al-chris/GEOFENCE/hardware/kicad/geofence_lawnmower.png

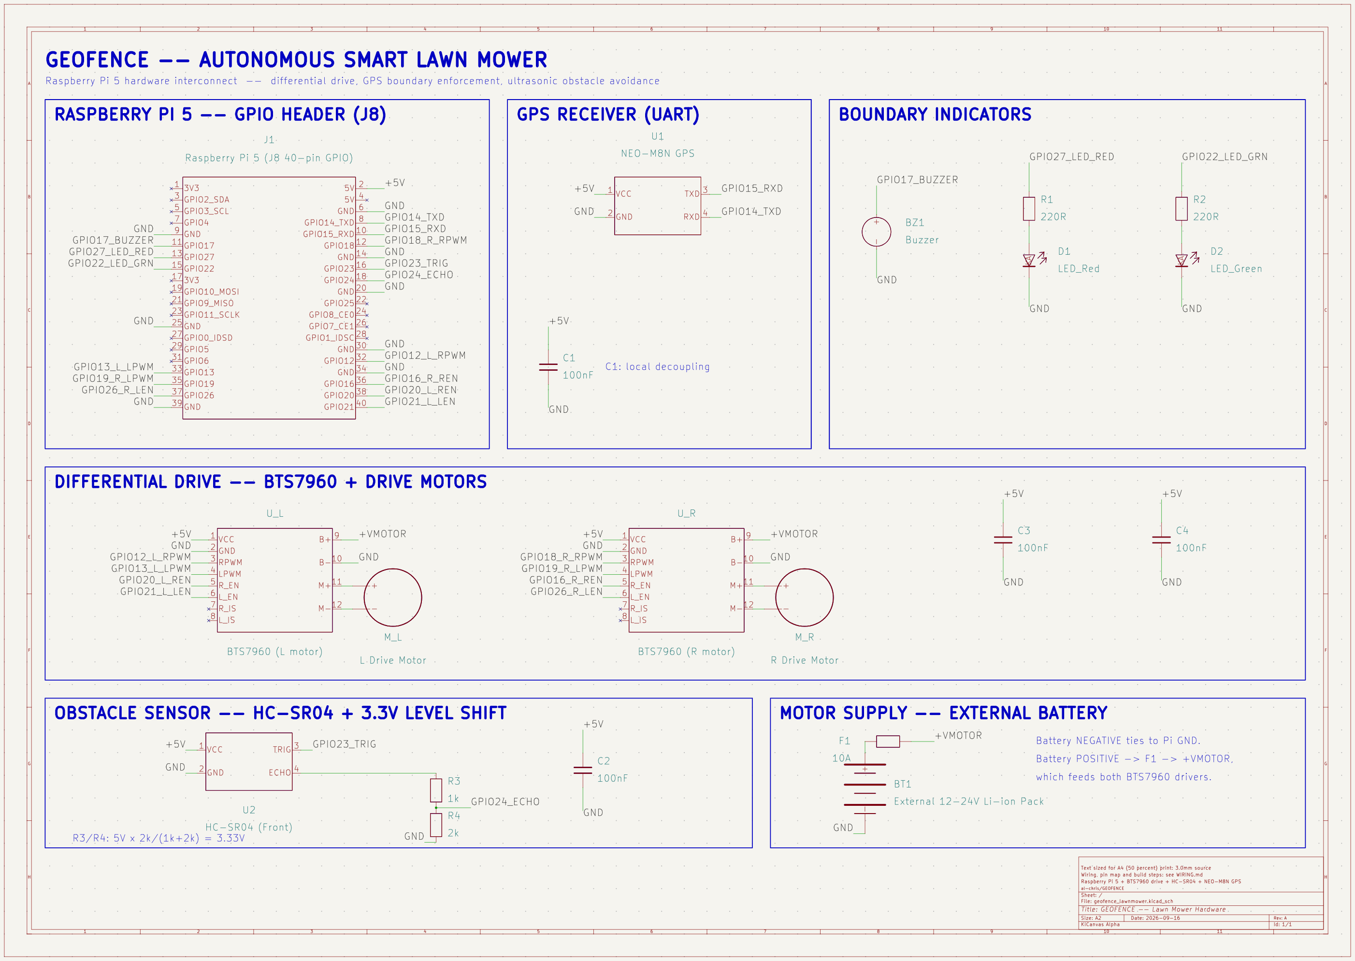
hardware/kicad/geofence_lawnmower.png
