al-chris/GEOFENCE/hardware/kicad/geofence_lawnmower.kicad_sch

## KiCad design hardware/kicad/geofence_lawnmower.kicad_sch (2026-09-16)

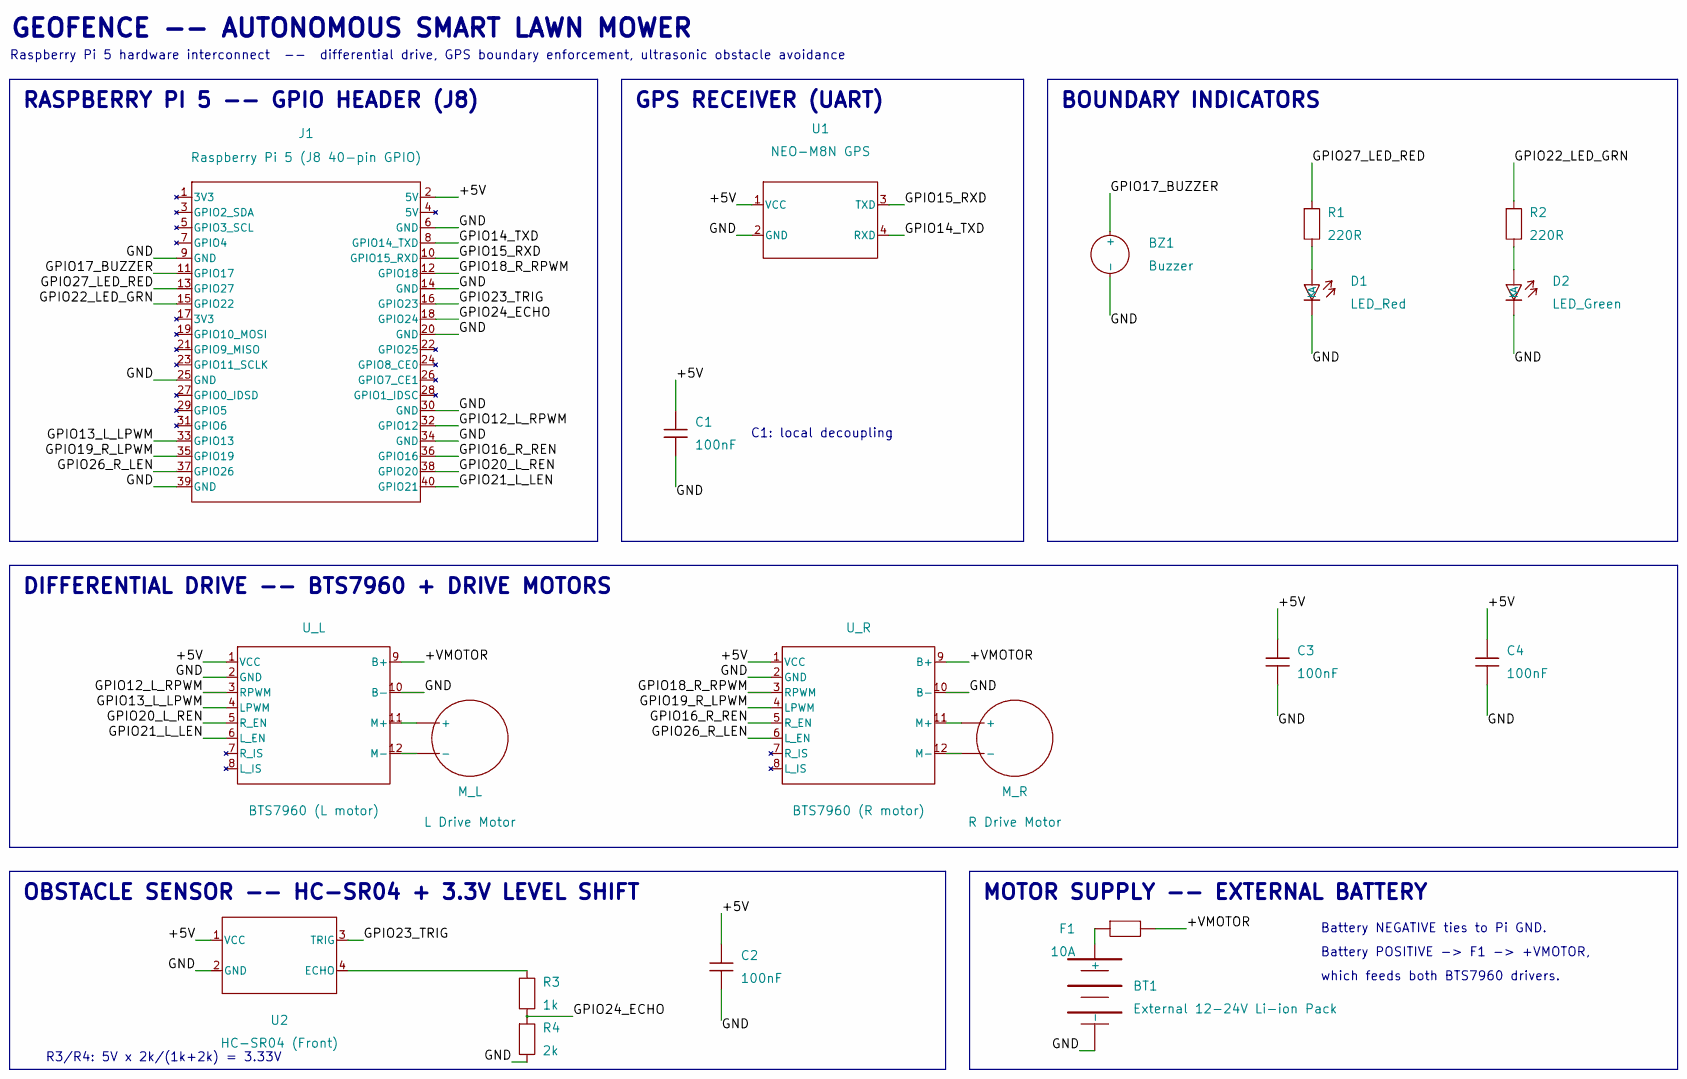
[picture p2: schematic geofence_lawnmower.kicad_sch]

Parts:
BT1: External 12-24V Li-ion Pack
BZ1: Buzzer
C1, C2, C3, C4: 100nF
D1: LED_Red
D2: LED_Green
F1: 10A
J1: Raspberry Pi 5 (J8 40-pin GPIO)
M_L: L Drive Motor
M_R: R Drive Motor
R1, R2: 220R
R3: 1k
R4: 2k
U1: NEO-M8N GPS
U2: HC-SR04 (Front)
U_L: BTS7960 (L motor)
U_R: BTS7960 (R motor)

Connections:
+5V: C1.1, C2.1, C3.1, C4.1, J1.2 (5V), U1.1 (VCC), U2.1 (VCC), U_L.1 (VCC), U_R.1 (VCC)
+VMOTOR: F1.2, U_L.9 (B+), U_R.9 (B+)
GND: BT1.2 (-), BZ1.2 (-), C1.2, C2.2, C3.2, C4.2, D1.2 (K), D2.2 (K), J1.6 (GND), J1.9 (GND), J1.14 (GND), J1.20 (GND), J1.25 (GND), J1.30 (GND), J1.34 (GND), J1.39 (GND), R4.2, U1.2 (GND), U2.2 (GND), U_L.2 (GND), U_L.10 (B-), U_R.2 (GND), U_R.10 (B-)
GPIO12_L_RPWM: J1.32 (GPIO12), U_L.3 (RPWM)
GPIO13_L_LPWM: J1.33 (GPIO13), U_L.4 (LPWM)
GPIO14_TXD: J1.8 (GPIO14_TXD), U1.4 (RXD)
GPIO15_RXD: J1.10 (GPIO15_RXD), U1.3 (TXD)
GPIO16_R_REN: J1.36 (GPIO16), U_R.5 (R_EN)
GPIO17_BUZZER: BZ1.1 (+), J1.11 (GPIO17)
GPIO18_R_RPWM: J1.12 (GPIO18), U_R.3 (RPWM)
GPIO19_R_LPWM: J1.35 (GPIO19), U_R.4 (LPWM)
GPIO20_L_REN: J1.38 (GPIO20), U_L.5 (R_EN)
GPIO21_L_LEN: J1.40 (GPIO21), U_L.6 (L_EN)
GPIO22_LED_GRN: J1.15 (GPIO22), R2.1
GPIO23_TRIG: J1.16 (GPIO23), U2.3 (TRIG)
GPIO24_ECHO: J1.18 (GPIO24), R3.2, R4.1
GPIO26_R_LEN: J1.37 (GPIO26), U_R.6 (L_EN)
GPIO27_LED_RED: J1.13 (GPIO27), R1.1
unnamed: BT1.1 (+), F1.1
unnamed: D1.1 (A), R1.2
unnamed: D2.1 (A), R2.2
unnamed: M_L.1 (+), U_L.11 (M+)
unnamed: M_L.2 (-), U_L.12 (M-)
unnamed: M_R.1 (+), U_R.11 (M+)
unnamed: M_R.2 (-), U_R.12 (M-)
unnamed: R3.1, U2.4 (ECHO)

Notes on the sheet:
GEOFENCE -- AUTONOMOUS SMART LAWN MOWER
Raspberry Pi 5 hardware interconnect -- differential drive, GPS boundary enforcement, ultrasonic obstacle avoidance
RASPBERRY PI 5 -- GPIO HEADER (J8)
GPS RECEIVER (UART)
BOUNDARY INDICATORS
DIFFERENTIAL DRIVE -- BTS7960 + DRIVE MOTORS
OBSTACLE SENSOR -- HC-SR04 + 3.3V LEVEL SHIFT
MOTOR SUPPLY -- EXTERNAL BATTERY
C1: local decoupling
R3/R4: 5V x 2k/(1k+2k) = 3.33V
Battery NEGATIVE ties to Pi GND.
Battery POSITIVE -> F1 -> +VMOTOR,
which feeds both BTS7960 drivers.
