al-chris/GEOFENCE/src/virtual_geofence/virtual_geofence/geofence_node.py

import os
import yaml
import numpy as np
import rclpy
from rclpy.node import Node
from rclpy.qos import qos_profile_sensor_data
from sensor_msgs.msg import NavSatFix
from geometry_msgs.msg import Twist
from shapely.geometry import Point, Polygon
from filterpy.kalman import KalmanFilter

try:
    import lgpio
    LGPIO_AVAILABLE = True
except ImportError:
    lgpio = None
    LGPIO_AVAILABLE = False


# Default GPIO configuration (Raspberry Pi 5: the 40-pin header lives on the
# RP1 chip, which is gpiochip4 on Ubuntu Server 24.04 — verify with `gpiodetect`).
DEFAULT_GPIO_CHIP = 4
DEFAULT_BUZZER_PIN = 17      # BCM 17 (physical pin 11)
DEFAULT_RED_LED_PIN = 27     # BCM 27 (physical pin 13)
DEFAULT_GREEN_LED_PIN = 22   # BCM 22 (physical pin 15)


class GeoFenceNode(Node):
    def __init__(self):
        super().__init__('geofence_node')

        # Parameters
        self.declare_parameter('boundary_coords', [0.0])
        self.declare_parameter('kalman_process_noise', 0.01)
        self.declare_parameter('kalman_measurement_noise', 2.5)
        self.declare_parameter('gpio_chip', DEFAULT_GPIO_CHIP)
        self.declare_parameter('buzzer_pin', DEFAULT_BUZZER_PIN)
        self.declare_parameter('red_led_pin', DEFAULT_RED_LED_PIN)
        self.declare_parameter('green_led_pin', DEFAULT_GREEN_LED_PIN)

        raw = self.get_parameter('boundary_coords').value

        # If parameter not provided or invalid, try loading config/boundary.yaml
        if not raw or len(raw) < 6 or len(raw) % 2 != 0:
            try:
                cfg_path = os.path.normpath(
                    os.path.join(os.path.dirname(__file__), '..', 'config', 'boundary.yaml')
                )
                if os.path.exists(cfg_path):
                    with open(cfg_path, 'r') as fh:
                        data = yaml.safe_load(fh)
                    raw_cfg = data.get('geofence_node', {}).get('ros__parameters', {}).get('boundary_coords', [])
                    if raw_cfg and len(raw_cfg) >= 6 and len(raw_cfg) % 2 == 0:
                        raw = raw_cfg
                        self.get_logger().info(f'Loaded boundary_coords from {cfg_path}')
            except Exception as e:
                self.get_logger().warning(f'Could not load fallback boundary file: {e}')

        if not raw or len(raw) < 6 or len(raw) % 2 != 0:
            self.get_logger().fatal(
                'boundary_coords must have >= 3 pairs of [lat, lon]. Shutting down.'
            )
            raise SystemExit(1)

        coords = [
            (float(raw[i + 1]), float(raw[i]))
            for i in range(0, len(raw), 2)
        ]
        self.boundary = Polygon(coords)
        self.get_logger().info(f'Boundary loaded with {len(coords)} vertices.')

        # GPIO setup (lgpio; optional on non-Pi platforms)
        # The buzzer and LEDs are plain digital outputs, so no PWM is needed.
        self._gpio_ready = False
        self._gpio = None
        self.gpio_chip = int(self.get_parameter('gpio_chip').value)
        self.buzzer_pin = int(self.get_parameter('buzzer_pin').value)
        self.red_led = int(self.get_parameter('red_led_pin').value)
        self.green_led = int(self.get_parameter('green_led_pin').value)
        if LGPIO_AVAILABLE:
            try:
                self._gpio = lgpio.gpiochip_open(self.gpio_chip)
                # You MUST claim every pin as an output before using it in lgpio.
                # All pins start LOW: do not assert "inside" at startup — wait
                # for the first GPS fix.
                for pin in (self.buzzer_pin, self.red_led, self.green_led):
                    lgpio.gpio_claim_output(self._gpio, pin, 0)
                self._gpio_ready = True
                self.get_logger().info(
                    f'lgpio ready on gpiochip{self.gpio_chip} — '
                    f'buzzer GPIO{self.buzzer_pin}, '
                    f'red LED GPIO{self.red_led}, '
                    f'green LED GPIO{self.green_led}'
                )
            except Exception as e:
                self.get_logger().error(
                    f'GPIO init failed: {e}. Running without GPIO. '
                    f'Run "gpiodetect" to verify the gpiochip number.'
                )
                self._close_gpio()
        else:
            self.get_logger().info('lgpio not available — running without GPIO.')

        # Kalman filter (state: lat, lon, lat_vel, lon_vel)
        q = self.get_parameter('kalman_process_noise').value
        r = self.get_parameter('kalman_measurement_noise').value

        self.kf = KalmanFilter(dim_x=4, dim_z=2)
        self.kf.x = np.zeros(4)
        self._kf_initialised = False

        dt = 0.1
        self.kf.F = np.array([
            [1, 0, dt, 0],
            [0, 1, 0, dt],
            [0, 0, 1, 0],
            [0, 0, 0, 1]
        ])
        self.kf.H = np.array([
            [1, 0, 0, 0],
            [0, 1, 0, 0]
        ])
        self.kf.P = np.diag([1e-4, 1e-4, 1e-6, 1e-6])
        self.kf.Q = np.eye(4) * q
        self.kf.R = np.eye(2) * r

        # State tracking
        self._last_inside: bool | None = None
        self._gps_msg_count = 0

        # ROS I/O
        self.subscription = self.create_subscription(
            NavSatFix, '/gps/fix', self.gps_callback, qos_profile_sensor_data
        )
        self.cmd_pub = self.create_publisher(Twist, '/cmd_vel', 10)
        self._startup_watchdog = self.create_timer(10.0, self._check_gps_stream)

        self.get_logger().info('Virtual Geo-fencing Node started.')

    def _check_gps_stream(self):
        if self._gps_msg_count == 0:
            self.get_logger().warning(
                'No messages received on /gps/fix yet. '
                'Start a GPS publisher (for hardware, run geofence_launch.py).'
            )
        else:
            # Disable watchdog after first successful reception.
            self._startup_watchdog.cancel()

    def gps_callback(self, msg: NavSatFix):
        self._gps_msg_count += 1
        # Some drivers may send a status field; skip invalid fixes
        status_ok = True
        if hasattr(msg, 'status') and getattr(msg.status, 'status', 0) < 0:
            status_ok = False

        if not status_ok:
            self.get_logger().warning('No GPS fix yet — skipping.')
            return

        lat_raw, lon_raw = msg.latitude, msg.longitude

        if not np.isfinite(lat_raw) or not np.isfinite(lon_raw):
            self.get_logger().warning('Invalid GPS coordinates received; skipping update.')
            return

        if not self._kf_initialised:
            self.kf.x = np.array([lat_raw, lon_raw, 0.0, 0.0])
            self._kf_initialised = True
            self.get_logger().info(
                f'Kalman filter initialised at ({lat_raw:.6f}, {lon_raw:.6f})'
            )

        z = np.array([lat_raw, lon_raw])
        self.kf.predict()
        self.kf.update(z)

        f_lat = float(self.kf.x[0])
        f_lon = float(self.kf.x[1])

        self.get_logger().debug(
            f'Raw: ({lat_raw:.7f}, {lon_raw:.7f})  '
            f'Filtered: ({f_lat:.7f}, {f_lon:.7f})'
        )

        point = Point(f_lon, f_lat)
        # treat points on the boundary as inside (covers), fall back to contains/touches
        try:
            inside = self.boundary.covers(point)
        except Exception:
            inside = self.boundary.contains(point) or self.boundary.touches(point)

        # Log initial state explicitly on first valid fix
        if self._last_inside is None:
            self.get_logger().info(f'Initial geofence state: {"INSIDE" if inside else "OUTSIDE"}')

        if inside != self._last_inside:
            self._last_inside = inside
            self._update_gpio(inside)
            if not inside:
                self.publish_stop()
                self.get_logger().warning(
                    f'BOUNDARY CROSSED → OUTSIDE | ({f_lat:.6f}, {f_lon:.6f})'
                )
            else:
                self.get_logger().info(
                    f'Re-entered boundary | ({f_lat:.6f}, {f_lon:.6f})'
                )

    def _update_gpio(self, inside: bool):
        if not self._gpio_ready or self._gpio is None:
            return
        try:
            lgpio.gpio_write(self._gpio, self.green_led, 1 if inside else 0)
            lgpio.gpio_write(self._gpio, self.red_led, 0 if inside else 1)
            lgpio.gpio_write(self._gpio, self.buzzer_pin, 0 if inside else 1)
        except Exception as e:
            self.get_logger().error(f'GPIO write error: {e}')

    def _close_gpio(self):
        """Drive the indicators off, release the claimed pins and close the chip."""
        if self._gpio is not None:
            for pin in (self.buzzer_pin, self.red_led, self.green_led):
                try:
                    lgpio.gpio_write(self._gpio, pin, 0)
                    lgpio.gpio_free(self._gpio, pin)
                except Exception:
                    # Pin was never claimed (failed init) — safe to ignore.
                    pass
            try:
                lgpio.gpiochip_close(self._gpio)
            except Exception:
                pass
        self._gpio = None
        self._gpio_ready = False

    def publish_stop(self):
        msg = Twist()
        self.cmd_pub.publish(msg)
        self.get_logger().info('Stop command published to /cmd_vel')

    def destroy_node(self):
        self._close_gpio()
        super().destroy_node()


def main(args=None):
    rclpy.init(args=args)
    node = GeoFenceNode()
    try:
        rclpy.spin(node)
    finally:
        node.destroy_node()
        rclpy.shutdown()


if __name__ == '__main__':
    main()
