al-chris/GEOFENCE/(commit log)

2026-04-15 Update GPIO setup to initialize green LED to LOW and wait for first GPS fix
    [geofence_node.py]
2026-05-09 initial gazebo simulation setup and documentation
    [agribot.urdf.xacro, field.sdf, model.sdf]
2026-05-09 switched to uv
2026-05-09 refactor: redesign robot to Lawnbot Pro and restructure project workspace
    - Redesigned robot model from 'Agribot' rover to 'Lawnbot Pro' autonomous mower.
    - Refactored URDF with low-profile chassis, 2-DOF cutting deck, and spinning blade.
    - Optimized simulation physics and spawn height (0.12m) to fix floating/sinking issues.
    - Realigned control panel visuals (GPS, SBC, LED strips) for a flush, centered layout.
    - Restructured project into a standard ROS 2 workspace with a dedicated 'src' directory.
    - Updated 'sim_launch.py' with comprehensive ROS 2 to Gazebo bridges for all sensors and actuators.
    - Enhanced 'setup.md' and package README with detailed manual keyboard control (teleop) gu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
    [agribot.urdf.xacro, field.sdf, lawnmower.urdf.xacro, model.sdf]
2026-05-09 feat: Created a new world in field.sdf and adjusted the mower's spawn position.
    [field.sdf]
2026-05-10 fix: Update geofence coordinates and adjust GPS publisher to reflect new location
    [lawnmower.urdf.xacro]
2026-05-10 fix: Adjust camera update rates and modify nadir camera orientation for improved performance
    feat: added rviz config
    [lawnmower.urdf.xacro]
2026-07-28 docs: update setup guide from Raspberry Pi 3 to Pi 5 UART configuration
2026-09-16 feat: Add motor and ultrasonic control for Raspberry Pi 5
    - Introduced `motor_ultrasonic_control.py` for rapid hardware testing of BTS7960 motors and HC-SR04 sensors.
    - Implemented `hardware_controller.py` to manage motor drivers and ultrasonic sensors with mock support.
    - Created `motor_controller_node.py` for ROS 2 integration, handling `/cmd_vel` commands and obstacle detection.
    - Updated launch files to include motor controller node and hardware parameters.
    - Added configuration for hardware parameters in `hardware_params.yaml`.
    - Enhanced setup documentation with wiring details for motors and sensors.
    - Added unit tests for hardware controller functionality, including motor speed clampi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
    [hardware_params.yaml]
2026-09-16 feat: Add KiCad schematic for full hardware interconnect
    Hand-authored KiCad 8 schematic (Raspberry Pi 5 J8 header, NEO-M8N GPS,
    2x BTS7960 differential drive, HC-SR04 + level-shift divider, boundary
    buzzer/LEDs, external motor battery + fuse) matching the pin mapping
    documented in WIRING.md. Work in progress -- pushing to verify rendering
    on kicanvas.org before merging.
    [geofence_lawnmower.kicad_sch]
2026-09-16 docs: Add README for the KiCad hardware schematic
    Explains what the schematic covers and how it was verified (kicanvas.org,
    with a programmatic dangling-wire check against kicanvas's own parsed
    schematic data) since no local KiCad install was available.
2026-09-16 fix: Resolve schematic layout collisions found on review
    - Move the page title up and shrink it, and give every zone frame a much
    bigger clearance before its contents (the Pi header was rendering with
    its top pin rows crowding/overlapping the page title and frame label).
    - Move the LED reference/value text clear of the light-emission arrow
    graphics (was overlapping the symbol on D1/D2).
    - Move the BTS7960 decoupling caps (C3/C4) above the driver body instead
    of squeezed into the left-side GPIO label column, where they collided
    with the RPWM/LPWM/REN/LEN net labels.
    - Add explicit rotation angle to every property "at" field (was 2-value,
    should be 3-value per the KiCad file format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
    [geofence_lawnmower.kicad_sch]
2026-09-16 fix: Correct pin-row rendering order and clear remaining header overlap
    kicanvas renders a symbol's stacked same-side pins with the largest local Y
    appearing visually first (top), the reverse of the source order -- verified
    directly against high-resolution captures of the live render (pin 1 was
    showing at the bottom of the Pi header and BTS7960 modules). Reversed the
    row-height assignment for the Pi header, BTS7960, GPS and HC-SR04 symbols so
    pin 1 reads at the top as expected; this only changes which physical row
    each pin number lands on; connectivity is unaffected since every wire is
    still attached via the pin's actual computed position.
    Also pushed the Pi header further down (pi_y 80 ->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
    [geofence_lawnmower.kicad_sch]
2026-09-16 fix: Move BTS7960 decoupling caps clear of the driver's pin rows
    The previous placement (just above the driver body) ended up colliding
    with the driver's own pin rows once the row-reversal fix changed where
    they render. Moved C3/C4 well clear into open space to the right instead
    of trying to track the driver's rendered extent.
    [geofence_lawnmower.kicad_sch]
2026-09-16 fix: Clear remaining title overlap on the GPS and ultrasonic zones
    Same issue as the Pi header (frame label too close to the module's top),
    just smaller since these are 4-pin modules -- a 14mm gap wasn't quite
    enough. Pushed the GPS module and HC-SR04 + divider down further, moved
    their decoupling caps down to match, and grew both frames to fit.
    [geofence_lawnmower.kicad_sch]
2026-09-16 fix: Correct schematic Y-axis convention so wires actually land on pins
    The sheet rendered completely broken: every symbol was mirrored about its own
    origin and not one wire touched its pin (label stubs floated in empty space
    beside J1). The generator placed instances and wires assuming
    screen_y = instance_y + local_y
    but KiCad draws an unrotated, unmirrored instance with
    screen_y = instance_y - local_y (placement transform [1,0,0,-1])
    because embedded lib_symbols are stored Y-up while schematic space is Y-down.
    This was invisible to the previous netlist self-check because the checker
    reused the generator's own (wrong) transform -- generator and checker agreed
    perfectly w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
    [geofence_lawnmower.kicad_sch]
2026-09-16 test: Add independent schematic verifier and pin-convention check
    verify_schematic.py re-parses the emitted .kicad_sch from scratch and re-derives
    every pin position using KiCad's real placement transform. It deliberately does
    not import the generator: the previous revision's self-check failed to catch a
    whole-sheet mirroring bug precisely because it reused the generator's own wrong
    assumption, so a checker that shares code with the thing it checks is worth
    very little here.
    It fails on unbalanced parentheses, dangling wire ends, pins that are neither
    wired nor no-connected, stray no-connect flags, off-grid connection points,
    symbol bounding-box overlaps, text overlaps, content overlapping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
    [check_pin_convention.py, verify_schematic.py]
2026-09-16 docs: Document the schematic generator, verifiers and coordinate convention
    The hardware README claimed the sheet had been verified via kicanvas's parsed
    schematic data with "no dangling nets", which was true of the check that was
    run and false of the file: that check shared the generator's coordinate
    assumption, so it agreed with a broken sheet. Rewrite the README around what is
    actually true and reproducible now.
    - Record the screen-vs-library coordinate convention and why getting it wrong
    is silent rather than loud.
    - Point at the three scripts and what each one proves.
    - State plainly that the file has not been through kicad-cli sch erc, because
    KiCad is not installed on the authori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
2026-09-16 fix: Scale schematic text for A4 printing and align the zone boxes
    The sheet is A2 but goes into reports on A4, i.e. a 50% linear reduction, so
    1.27mm text was landing at ~0.64mm on paper -- too small to read comfortably.
    Text is now 3.0mm (pin names 2.5mm, since they have to fit inside a fixed-pitch
    symbol body), which prints at ~1.5mm: slightly better than a native A4 KiCad
    schematic. Symbol bodies and pin pitches were scaled to match, because a symbol
    is a drawing convention, not a physical dimension -- nothing is drawn to scale
    and the header still mirrors the real J8 pinout.
    Layout, addressing the review comments:
    - The worksheet title block is a fixed 108x32mm rectangle anchored to t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
    [geofence_lawnmower.kicad_sch]
2026-09-16 fix: Clear the buzzer from its zone border and fill the sheet width
    Two issues from review.
    The buzzer overlapped the left border of its own zone box: the circle is
    centred on BZ1 and has a 6.35mm radius, so at x 330.2 it reached back to
    323.85 while the zone started at 326. The indicators have been spread across a
    wider zone (the buzzer now sits at 384.81, well inside), which also stops that
    zone looking cramped.
    The right-hand side of the sheet was largely dead margin: the drawing occupied
    x 18..470 of a 594mm sheet, leaving a wide empty band with only the title block
    in it. Every zone row now spans the full usable width (x 18..574) and the
    content is spread to use it, so the sheet reads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
    [geofence_lawnmower.kicad_sch]
2026-09-16 docs: Add a rendered PNG snapshot of the schematic sheet
    Adds `geofence_lawnmower.png` — the full A2 sheet at 2804 x 1988 px, which is
    about 240 dpi when scaled onto A4, so it can be dropped straight into a report.
    Exported from kicanvas rather than plotted from KiCad, since there is no KiCad
    on this machine. Worth recording for anyone repeating it: kicanvas's *download*
    button exports the `.kicad_sch` source, not a picture, so the image instead
    comes from reading back the viewer's own canvas. kicanvas sizes that canvas to
    the browser viewport, so enlarging the window (3600 x 2500 here) is what sets
    the exported resolution. The README documents the three steps.
    The PNG is a snapshot, not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
2026-09-16 feat: Replace RPi.GPIO with lgpio for Raspberry Pi 5 compatibility and add standalone test scripts for peripherals
    [geofence_node.py, test_indicators.py, test_motors.py, test_ultrasonic.py]
2026-09-21 feat: Add GPS driver launch configuration and handle missing package gracefully
2026-09-21 fix: Pin NumPy version to <2.0 in requirements and setup documentation to prevent compatibility issues
